Edmarici/maskLib/Radial_Stub_LPF/HFSS/rev21_analysis_report.txt

==============================================================================
Rev 21 close-out analysis - frozen configuration filter_BB_v4_pass9of9
  source: v6_confirm_S21.csv (2301 pts, 0.50-14.00 GHz, tight mesh)
==============================================================================

Q3 - BUFFER MODES ACROSS THEIR STATED +/-0.15GHz UNCERTAINTY
(no new solve; the scorecard already scores these rows as a worst-case)
  buffer 1  [4.35, 4.65] GHz, 31 solved pts: nominal -28.08, WORST -27.49 @ 4.580 GHz -> PASS (+7.49 dB)
  buffer 2  [4.85, 5.15] GHz, 31 solved pts: nominal -30.11, WORST -28.82 @ 4.920 GHz -> PASS (+8.82 dB)

Q2 - SENSITIVITY

  (a) GLOBAL perturbations - exact frequency rescale of the measured curve
      case                    bf 1    bf 2    st 1    st 2    st 3    st 4    st 5    st 6    st 7
      nominal               -27.49  -28.82  -28.54  -28.79  -27.06  -33.16  -21.43  -22.38  -22.56
      all lengths +0.25%    -27.49  -28.83  -30.75  -28.48  -27.12  -34.59  -21.61  -22.37  -22.64
      all lengths -0.25%    -27.49  -28.83  -26.15  -29.15  -27.00  -32.11  -21.23  -22.39  -22.49
      eps_eff +1%           -27.49  -28.82  -32.93  -28.21  -27.19  -36.69  -21.75  -22.35  -22.74
      eps_eff -1%           -27.17  -28.82  -23.39  -29.55  -26.94  -31.31  -21.00  -22.40  -22.43
      WORST                 -27.17  -28.82  -23.39  -28.21  -26.94  -31.31  -21.00  -22.35  -22.43
      margin                 +7.17   +8.82   +3.39   +8.21   +6.94  +11.31   +1.00   +2.35   +2.43
      -> below 20dB under any global perturbation: NONE

  (b) SINGLE-STUB 1% length error - nearest-null local shift (approximate)
      mode            GHz  nominal     worst    margin   nearest null
      buffer 1      4.500   -27.49    -21.09     +1.09   4.370 (S1), 130 MHz away
      buffer 2      5.000   -28.82    -28.82     +8.82   4.870 (S2), 130 MHz away
      storage 1     5.792   -28.54    -14.65     -5.35   5.900 (S6), 108 MHz away
      storage 2     6.160   -28.79    -27.79     +7.79   5.900 (S6), 260 MHz away
      storage 3     6.528   -27.06    -26.85     +6.85   6.970 (S4), 442 MHz away
      storage 4     6.897   -33.16    -30.16    +10.16   6.970 (S4), 73 MHz away
      storage 5     7.265   -21.43    -20.34     +0.34   7.550 (?), 285 MHz away
      storage 6     7.633   -22.38    -22.33     +2.33   7.550 (?), 83 MHz away
      storage 7     8.001   -22.56    -22.35     +2.35   7.550 (?), 451 MHz away
      -> below 20dB: storage 1

  (c) LINEWIDTH +/-5um - from the validated extraction, not modelled
      epseff_extraction_status.md records the field-plot-verified 6GHz point:
        w=70um  eps_eff 5.6795  Zpi 69.71 ohm
        w=125um eps_eff 5.6826  Zpi 69.70 ohm
      A 55um width change moves eps_eff <0.1% and Zpi ~0.01%. A +/-5um bias
      is ~1/11 of that, so <0.01% on both - negligible against the +/-1%
      eps_eff case above, which already passes. Expected physically: with no
      ground plane the mode is set by the bore, not the strip width.
      NOTE the same file records that the SWEPT eps_eff(f) data is
      non-physical and untrusted; only the 6GHz point is in use.

Q4 - DATA FOR THE NOTE

  (1) stub table
      stub    label       realized um   runs   gap um d_perp um  tee y um     fold
      S1      4.5GHz     8749.7213596      2     1000      1200   30000.0       -1
      S2      4.7GHz     9776.0927822      3      400      1000   27500.0       +1
      S3      5.3GHz     7395.2928339      2      400      1000   25000.0       +1
      S4      6.1GHz     5581.3136360      2      400      1000   22500.0       -1
      S5      7.0GHz     4307.8078628      2      400      1000   20000.0       +1
      S6      6.0GHz     7379.3226508      2      400      1000   17500.0       -1

  (2) null inventory, 0.5-14GHz, with HOW ownership was established
        4.370 GHz  S1   deletion   Rev19 B1 removed S1 and 4.325 vanished; tracked the Rev20 trim to 5MHz
        4.870 GHz  S2   assigned   never deletion-tested
        5.470 GHz  S3   assigned   never deletion-tested
        5.900 GHz  S6   deletion   Rev19 B4 removed S6 and this null vanished; moved with S6 length in Rev20 B3
        6.970 GHz  S4   deletion   Rev19 B1b census removed S4 and 6.890 vanished
        7.550 GHz  ?    unknown    needs S6 present (vanishes on S6 deletion) but ignores S6 length - Rev21 Q1
        8.730 GHz  S5   assigned   never deletion-tested
        9.965 GHz  -    unowned    survived S6 deletion AND three S6 lengths - explicitly NOT S6
       11.360 GHz  -    unowned    moved +2.3% while S6 grew 1.911x - not S6
       12.375 GHz  -    unowned    moved -1.3% while S6 grew 1.911x - not S6
      -> 3 of 10 deletion-confirmed; 3 assigned but never tested; 3 unowned.

  (3) k_eff on ONE definition
      DEFINITION A (used everywhere, verified below): k_eff = f_bare / f_null,
      f_bare = c/(4*L*sqrt(eps_eff)) with L = drawn centreline INCLUDING arc
      length, i.e. d_perp + turn_arc + n*run_length - the quantity
      folded_stub() solves and dims JSON reports as realized_length_um.
      case                                L um     null    k_eff   provenance
      foldexp 3run/400um             6987.9008    6.830   0.6589   isolated, Rev17 B2
      foldexp 2run/1000um            6987.9008    5.680   0.7923   isolated, Rev17 B2
      foldexp L-geometry             6987.9008    5.050   0.8911   isolated, Rev17 B2
      foldexp straight               6987.9008    5.450   0.8257   isolated, WIDE bore - not comparable
      S6 topology 2run/400um         6436.9032    6.780   0.7205   isolated, Rev20 B2
      S6 in cascade, old len         6436.9032    6.640   0.7357   cascade, Rev19 B4
      S6 in cascade, frozen          7379.3227    5.900   0.7223   cascade, Rev20 confirm
      S1 in cascade, pre-trim        8820.2836    4.340   0.8215   cascade, Rev19 B3
      S1 in cascade, frozen          8749.7214    4.370   0.8224   cascade, Rev20 confirm
      S2 in cascade, frozen          9776.0928    4.870   0.6605   cascade, ASSIGNED not tested
      RESOLVED: the suspected length-reference discrepancy does NOT exist.
      Every k_eff quoted in DESIGN_NOTES recomputes to <0.002 under
      definition A. The alternative (straight runs only, arcs excluded)
      would give k_eff > 1 for two cases, which is unphysical under the
      fold-cancellation reading, so it was never in use.
      The REAL inconsistency is the numerator: S6 was quoted at 0.6886,
      computed against the geometric MEAN of a null PAIR, while every other
      entry uses a measured null. That pair reading is withdrawn
      (sec 18.3), so 0.6886 is retired and replaced by 0.7357 (old length)
      / 0.7223 (frozen length). A second case: sec 14 quotes S2 at 0.664,
      which is 4.845GHz not the 4.760GHz the same sentence cites - again a
      numerator mismatch, not a length one.

  (4) mesh calibration
      probe (dS 0.02, ~1h) vs tight (dS 0.005, ~7h), measured on TWO geometries:
        Rev20 B1, pre-move geometry : mean 0.61 dB, worst 2.25 dB
        Rev20 B3, frozen geometry   : mean 0.45 dB, worst 1.85 dB
      worst row is buffer 2 both times - it is a worst-across-window row, so
      it samples wherever the grid lands. Scorecard work can use probe mesh.
      NULL POSITIONS are the exception: probe reads them a mean 14MHz (worst
      35MHz) LOW, same direction at all seven nulls, because an Interpolating
      sweep reconstructs sharp minima poorly. Length decisions need the
      discrete window.

  wrote C:\Users\epm114\Desktop\Masklib\Radial_Stub_LPF\HFSS\rev21_stub_table.csv

  wrote C:\Users\epm114\Desktop\Masklib\Radial_Stub_LPF\HFSS\rev21_keff_table.csv
  wrote C:\Users\epm114\Desktop\Masklib\Radial_Stub_LPF\HFSS\rev21_null_inventory.csv
==============================================================================
