Edmarici/maskLib/(list of files, cad)

Other CAD files:
Radial_Stub_LPF/DXF/filter_BB_CHIP_BB.dxf
Radial_Stub_LPF/DXF/filter_BB.dxf
