Edmarici/maskLib/(commit log)

2026-07-21 add fill_basemetal_from_xor helper to derive BASEMETAL fill from XOR gap layer
    merge()+hulls()+smoothed() over the XOR (CPW gap) layer to flood-fill the
    conductor footprint for XOR-convention chips, without bridging gaps
    between electrically distinct trace runs (an earlier bridging attempt
    shorted adjacent resonators - see the function's own docstring).
2026-07-21 add tapped_hairpin_filter and stepped_impedance_lpf CPW filter primitives
    Dimensions come straight from a Nuhertz Filter Solutions synthesis run
    (microstrip, Si, 500um) - a starting point, not final: this stack has no
    backside metal (CPW, not microstrip), so gap width still needs picking
    independently, and every length will need HFSS re-extraction once the
    real bare-chip/package environment is modeled (see the functions' own
    docstrings).
2026-07-21 add LC_Filter_* ladder-filter drawing helpers
    Standalone inductor/capacitor primitives (LC_Filter_ind1/ind2/
    ind_rects1/ind_rects2/cap1/cap2) for an LC ladder filter layout.
2026-07-21 add SNAIL standalone device combining FlagPads, JJ_chain, and flux_transformer
    Same composition as Snailmon3D but with pad and flux-transformer
    dimensions exposed as top-level parameters so a specific already-
    simulated design can be reproduced directly, including FlagPads' new
    flag_offset for its asymmetric pad pair.
2026-07-21 consolidate CPS line width/gap into shared params in Fast_Flux_Full
    Replaces the pad taper's hardcoded width/gap and the loop's separate
    thin_w/thin_s with one cps_w/cps_s pair reused end-to-end (taper, pads,
    hairpin filter via its new w/s override, loop), and drops two unused
    CPS_structure calls (c5/c6) and a redundant CPW_launcher call.
2026-07-24 ignore AEDT/HFSS solver-cache and generated output artifacts
    ~5000 untracked AEDT project/solver-cache files (.aedtresults/, .pyaedt/,
    lock/semaphore sidecars, ~1.1GB) had accumulated across Hairpin_Filter/ and
    Radial_Stub_LPF/ - every driver script in this repo regenerates its own
    .aedt project and geometry fresh from Python each run, so none of it is
    load-bearing. Also excludes .gds outputs (only .dxf was previously
    covered) and per-script HFSS/ analysis-output directories.
2026-07-24 add standalone hairpin bandpass filter test chip + HFSS S12 export
    n=4 Nuhertz-synthesized tapped CPW hairpin bandpass filter (~4.5GHz),
    launcher-to-launcher, with no stepped-impedance lowpass and no SNAIL
    keep-out - a clean two-port test structure for the bandpass filter alone,
    isolated from SNAIL_Pump_Filter.py's full floorplan. Every electrical
    dimension is a placeholder pending HFSS re-extraction in the real
    (CPW, package-grounded) environment. Hairpin_Filter_HFSS.py drives the S12
    export via hfssExport.py's GDS->HFSS bridge; verify_hfss_export.py is the
    local (no-Ansys) regression check on that geometry replay.
2026-07-24 add standalone SNAIL device test chip
    Asymmetric pad pair -> 3-big-JJ + 1-small-JJ loop -> flux-transformer
    coupler, via the new SNAIL() function in qubitLib.py. Verifies the SNAIL
    device geometry in isolation before wiring the flux transformer into a
    pump-line feed (SNAIL_Pump_Filter.py). Draws positive metal directly
    (FlagPads/JJ_chain/smallJJ/flux_transformer via SolidPline/dxf.rectangle),
    not the XOR-gap CPW convention used elsewhere in this codebase, so no
    fill_basemetal_from_xor step applies here.
2026-07-24 add SNAIL pump-filter floorplan sanity-check chip (Rev 2)
    Pump port (coupling-pin capacitive pad) -> n=4 Nuhertz-synthesized tapped
    CPW hairpin bandpass filter (~4.5GHz) -> stepped-impedance lowpass cleanup
    -> SNAIL keep-out, on a 7x40mm bare c-plane sapphire chip. Every electrical
    (CPW, package-grounded) environment - this pass is floorplan geometry only,
    not a tuned design. Out of scope: HFSS retuning, open-stub notches, actual
    SNAIL geometry (see SNAIL/SNAIL.py), the BASEMETAL XOR boolean (downstream
    in KLayout).
    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
2026-07-24 add L30/L45 radial-stub lowpass ladder family + HFSS verification
    Chebyshev II/elliptic butterfly-branch (stalk+fan) lowpass ladders, L30
    (orthogonal-branch variant included) and L45 - each shunt branch is a
    stalk (series L) + fan (shunt C), zero at the branch's series LC
    resonance. Predecessor to the L60 family and, later, the filter_BB
    quarter-wave-stub pivot (see notebooks/L*_design_notes.md for the full
    per-design derivation and HFSS findings). *_HFSS.py scripts drive the
    pyEPR driven-modal S21 extraction; verify_*.py scripts are the local
    (no-Ansys) geometry-replay regression checks each *_HFSS.py's geometry
    source depends on.
2026-07-24 add L60 elliptic fan-ladder filter + real Al cavity package sim
    Converged elliptic radial-stub ladder (fallback/comparison design,
    retained after the later filter_BB pivot). filter_L60_HFSS.py: Phase 1
    open-sim-volume/proxy-ground sanity run. filter_L60_package_HFSS.py:
    Phase 2, replaces the proxy ground with a real cylindrical PEC bore +
    sapphire substrate package model - the real-package sim that first showed
    the fan-ladder's shunt capacitance starving against the round bore wall
    (DESIGN_NOTES Sec. 5), motivating the filter_BB quarter-wave-stub pivot.
2026-07-24 add eps_eff/Zpi calibration pipeline for the bare-strip-in-bore line
    pyaedt wave-port eigenmode extraction (multi-mode Gamma/Zo post-processing
    pyEPR has no wrapper for): bare 70um/125um strip on anisotropic sapphire
    (9.4,9.4,11.6) in the real 7mm bore, single-frequency ports-only setups
    (a frequency sweep of the port solve was found to produce garbage - frozen
    port solution evaluated across the sweep, not real dispersion - see
    epseff_extraction_status.md). Measured eps_eff=5.681, |Zpi|~69.7ohm
    (width-independent) - the calibration filter_BB.py's quarter-wave stub
    lengths are built from. plot_epseff_mode.py renders the mode field for
    visual strip-vs-cavity-mode verification.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
2026-07-24 add Rev 11 elliptical/stadium-bore parametric study
    Tests whether flattening the package bore cross-section (oval/stadium,
    major axis fixed at 6.985mm, bore_h swept 6.985mm down to 1.0mm) restores
    enough shunt capacitance to resurrect the L60 fan-ladder and/or
    meaningfully shifts filter_BB's eps_eff. Three models: bare-strip
    eps_eff/Zpi (pyaedt multi-mode wave-port, oval_bore_epseff_HFSS.py), an
    unfolded real-P4-dimensioned branch pair and an unfolded filter_BB-style
    stub (pyEPR driven-modal S21 zero-finding, oval_bore_branch_stub_HFSS.py).
    oval_study_analysis.py merges the raw CSVs, plots, and computes the
    verdict against the study's explicit decision criteria.
    VERDICT (recorded in DESIGN_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
2026-07-24 add filter_BB quarter-wave stub pivot, Stage A protection sim, Rev 12 first light
    filter_BB.py (Rev 8 pivot): six-stub open-circuit quarter-wave band-block
    filter - zeros depend only on length and eps_eff, not capacitance to
    ground, so the fan-starved-in-the-round-bore failure mode that killed L60
    (see the oval-bore-study commit) cannot touch it. Rev 12: all stubs
    collapsed to 70um (measured |Zpi| is width-independent - width bought
    nothing), runtime report now prints target-vs-predicted f_zero per stub,
    and a dims JSON is exported for the HFSS quick-look pipeline.
    filter_BB_stageA_HFSS.py: real pin coupler + SNAIL-side lumped port,
    solves for Re[Z_snail](f) and coax->SNAIL transfer - the a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
2026-07-28 filter_BB: lock S7+v2 baseline geometry and pre-solve predictions (Rev 16)
    Fixes a real bug: bumping PREVIOUS_PASS_DIMS_JSON/DASHBOARD_CSV to pass-3's
    own output projected an unintended further f~1/L correction onto S2-S6
    (the intent was "S1 frozen at v2, S2-S6 unchanged from pass-3" per Rev 15's
    own definition). S2-S6 are now frozen via explicit dl_um constants copied
    from their pass-3 dl_um_seed values; PREVIOUS_PASS_* point at nonexistent
    files so no stub gets a live-recomputed seed anymore.
    filter_BB_circuit_model.py: fixed a null-to-stub matching bug (per-label
    nearest-search could double-assign one model null to two labels - S3/S4
    both matched 5.633GHz identically) by switching to the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
    [s7v2_predictions.csv]
2026-07-30 filter_BB v3: quantify the fold penalty, adopt an L-stub for S1, drop S7 (Rev 17)
    Fold-geometry experiment (new filter_BB_fold_experiment_HFSS.py): one stub
    alone on a matched through-line, four geometries at an IDENTICAL 6987.9um
    drawn length, all in the real 7000um bore. Measured k_eff (= bare quarter-wave
    frequency / measured null frequency; 1.0 = drawn length resonates where
    lambda/4 says):
    3 parallel runs, 400um gap -> 6.830GHz, k_eff 0.659
    2 parallel runs, 1000um gap -> 5.680GHz, k_eff 0.792
    L, single bend, 2500um standoff -> 5.050GHz, k_eff 0.891
    Monotonic in both fold count and run gap - antiparallel adjacent runs cancel,
    shortening the effective electrical length and pushin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
    [foldexp_results.csv]
2026-07-31 bank filter_BB v3 results and tag it (Rev 18 D0)
    v3 is the first configuration to pass the SNAIL criterion: S21@4.5GHz =
    -33.56dB vs a <=-20dB target (v2+S7 was -10.94dB).
    Geometry: S1 = L-stub @7841.97um targeting 4.5GHz, S7 deleted, S2-S6 frozen.
    filter_BB.py at this commit is the source of truth; DXF/GDS regenerate from it
    with identical geometry (verified: dims JSON hash stable across runs, merged
    region 1 polygon / 7476841.79um^2). Their file hashes do churn per-run, but
    only from the DXF header's TDCREATE/TDUPDATE timestamps, so the blobs
    themselves are not committed - the dims JSON is the deterministic record.
    Force-added because HFSS/ is gitignored; these solve outputs cost hours o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
    [v3_confirm_S21.csv, v3_confirm_convergence.csv, v3_confirm_dashboard.csv, v3_confirm_needles.csv, v3_confirm_passband.csv, v3_confirm_valleys.csv]
2026-07-31 filter_BB: refold S1 as a wide-gap single fold pointing away from S3 (Rev 18)
    v3's L-stub put S1's open end 783um from S3's fan - the tightest pair in the
    design, and both are voltage antinodes - and S3's -66dB notch vanished from the
    v3 sweep. This refolds S1 to keep its length while moving its far end away.
    S1: 2 runs at a 1000um gap (bend radius 535um), d_perp 1200um, folded NORTH.
    Drawn length 8820.28um, from the fold experiment's measured k_eff 0.792 for
    this exact geometry. S2-S6 and all six tee positions are byte-identical
    (verified field-by-field against the filter_BB_v3 tag's dims JSON).
    The handoff specified a SOUTHWARD fold turning back before S3's latitude.
    That is geometricall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
2026-07-31 filter_BB: Rev 18 probe result + six revisions of design notes (Rev 12-18)
    BB_design_notes.md had been unwritten since the first pre-HFSS build - it
    still listed EPS_EFF=5.5 as an open placeholder and a 4.2GHz S1. Adds Part
    II covering Rev 12-18: the impedance triple, the measured fold penalty and
    the architecture rule it implies, v3 as the first passing configuration,
    the unresolved null attribution, the S1<->S3 coupling and this refold, and
    the process lessons. Marks the old sections as historical rather than
    deleting them - the method notes still apply.
    Rev 18 probe: CASE 1. The 4.7-5.3GHz hole improved 14.85dB (-7.39 ->
    -22.23dB) and S21@4.5GHz still passes at -23.08dB. But the hole mov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
    [v3f_singlefold_S21.csv]
2026-07-31 filter_BB: Rev 19 B0 mode-comb scorecard + B1 deletion test harness
    New acceptance spec is a 9-row table lookup at discrete mode frequencies,
    not a worst-in-band scan. Buffer rows report the WORST S21 across the full
    +/-0.15GHz uncertainty rather than the value at the nominal centre - a
    narrow null centred on 4.5GHz that degrades at 4.65GHz is not protection.
    B0 result: probe and v3 BOTH score 8/9. They differ in which mode flags -
    probe at storage 1 (5.792GHz, -18.21dB, 1.8dB short), v3 at buffer 2
    (5.000GHz, -7.39dB, 12.6dB short). So the probe is ahead on severity, but
    not 8-vs-5 as the handoff estimated, and its margin structure is thinner:
    3 of 9 modes within 2dB of the line versus v3s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
    [comb_scorecard.csv]
2026-07-31 filter_BB: Rev 19 B1 - S1 identified by deletion, and it owns 4.325GHz
    Deleting S1 removes the 4.325GHz null and no other. Settles the attribution
    question open since Rev 16, and corrects Rev 18s probe report, which named
    4.855GHz as S1s null - that is wrong, 4.855 survives S1s deletion.
    Coupling, measured rather than inferred: S1 shifts only its nearest
    neighbour (4.855 -> 4.800, -1.1%). The 5.480/6.890/8.135 nulls move
    <=0.36%, at or below the noise floor for two runs solved at different mesh
    settings. This undercuts Rev 18s reading that S1 was strongly hybridising
    with S3 - if deleting S1 outright barely moves that null, S1 cannot explain
    the 6.6% v3->probe shift attributed to it.
    B2 as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
    [v3f_delete_S1_S21.csv]
2026-07-31 filter_BB: Rev 19 B1b - full-range null census + S4 deletion test
    Two questions, one script, deliberately mesh-matched.
    Q1: sweeps 0.5-14GHz before anyone concludes a stub is dead. Every missing
    notch in this campaign so far has been a search window that was too narrow,
    and the Rev 18 probe only looked at 3.5-9.0GHz. If six nulls exist over the
    full range then nothing is missing and repair beats adding a 7th stub.
    Q2: deletes S4 to find which null is its own and which neighbour moves.
    B1 ruled S1 out as a coupling partner but that does not rule out
    hybridisation elsewhere - S3/S4 and S4/S5 are the remaining candidates and
    this discriminates.
    Both designs build at the SAME 6.0GHz single-po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
2026-07-31 filter_BB: Rev 19 B1b - 12 nulls not 5, S4 owns 6.890GHz, S4-S5 coupling measured
    Q1: the intact filter has 12 nulls over 0.5-14GHz, seven of them above
    9.0GHz where the Rev 18 probe never looked. The 5-nulls-for-6-stubs mystery
    was a search-window artifact, the same failure mode as every earlier
    missing-notch error. Nothing is missing; repair beats adding a 7th stub.
    Q2: deleting S4 removes the 6.890GHz null. S4 is the second stub identified
    by deletion. I had guessed 6.890 was S5 - wrong, and that is the second
    attribution guess this revision has overturned.
    Coupling FOUND, at matched mesh: deleting S4 moves the 8.125GHz null to
    8.375GHz, +3.1%. That is ~10x S1s effect and well clear of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
    [v3f_census_delS4_S21.csv, v3f_census_intact_S21.csv]
2026-07-31 filter_BB: Rev 19 B2 - retarget S6 from 8.0 to 5.98GHz (unfreezes S6)
    S6's null sat at 9.970GHz, above the 8.001GHz top of the mode comb, so it
    contributed nothing to the acceptance spec - storage 7 is covered by S5's
    8.125 null. Moving it to 5.98GHz, the midpoint of the two comb modes
    stranded in the 1.410GHz gap between S3 (5.480) and S4 (6.890), puts
    storage 1 and storage 2 each ~185MHz from a null instead of bullseyeing one
    and leaving the other exposed. Resulting spacings 0.500 and 0.910GHz, both
    inside the <=1.0GHz valley rule.
    Length from S6's OWN measured k_eff (bare 8.1447 / null 9.970 = 0.81692):
    6436.90um drawn, dl_um 1178.4494. Not extrapolated from another stub's
    geometry - tha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
2026-07-31 filter_BB: Rev 19 B3 - S6 retarget did NOT land; inferred assignment refuted
    The 9.970GHz null survived at 9.965GHz after S6 was lengthened x1.667, and
    no null appeared near the 5.98GHz target. 9.970 was never S6's, so the
    k_eff-consistency assignment in e196cce was wrong and the length computed
    from it (6436.90um) has no basis. The confirmation script's own self-check
    caught this rather than the result being read as a success.
    Design status, mesh matched to v3 (delta_S 0.005, 5 passes, final 0.0012):
    8/9 PASS, same as before. Every mode improved except the one this change
    targeted - storage 1 went -18.13 -> -15.76dB, so the sole flag got 2.4dB
    WORSE while buffer 1/2 gained ~2.5dB each and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
    [v4_comb_S21.csv, v4_comb_comb_scorecard.csv]
2026-08-01 filter_BB: Rev 19 B4 - S6 owns a null PAIR (6.640 + 7.580GHz), measured
    Cleanest attribution of the campaign: S6 deleted at B3's exact mesh, via the
    same script with --delete so configuration cannot drift. Two nulls vanish,
    6.640 and 7.580GHz. Every other null survives within 0.3%.
    S6 does not produce one null, it produces a SPLIT PAIR - ratio 1.1416,
    i.e. +/-6.84% about a geometric mean of 7.094GHz. That is why every
    k_eff-consistency assignment this revision failed: they all assumed one null
    per stub. It also explains the census finding exactly 12 nulls for 6 stubs.
    S6's real k_eff to the pair centre is 0.6886, not the 0.8169 assumed in B2,
    so the retarget landed 18.6% high - at 7.094GHz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
    [v4_delS6_S21.csv, v4_delS6_comb_scorecard.csv]
2026-08-01 filter_BB: Rev 20 tooling - probe-mesh option + split-pair gap harness
    Three tooling changes, no geometry touched yet.
    1. filter_BB_rev19_confirm_HFSS.py gains --mesh probe|confirm.
    The Rev 20 handoff asks for B1 (the S1 trim) at probe settings because a
    confirm-mesh solve costs ~7h here against ~1h for a probe one. But a
    probe-mesh scorecard cannot be read on absolute dB against B3/B4's
    confirm-mesh numbers, and storage 1's flag status is a threshold call with
    only 4.2dB in it - comparing across meshes is exactly the confound that
    made B3 unattributable.
    So B1 runs as a PAIR at probe mesh: untrimmed baseline first, then the
    trim, and the trim is judged on the mesh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
2026-08-01 filter_BB: Rev 20 B2 - two disk-only findings on the split pair, no solve spent
    Both come from re-reading files already on disk. No AEDT time.
    FINDING 1 - no isolated fold variant ever produced a pair.
    Re-read the Rev 17 fold experiment's own saved 0.5-14GHz coarse sweeps
    (HFSS/foldexp_*_S21.csv). Each variant has exactly ONE resonance across the
    full band: V-fold-current 6.830GHz, V-fold-wide 5.680GHz, V-L 5.045GHz. With
    the depth threshold removed entirely each trace has four local minima - the
    real null plus three shallow features near 1.9, 8.1 and 11.6GHz that sit
    within a few hundred MHz of each other across all three variants and are
    therefore harness artifacts, not stub resonances.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
2026-08-01 filter_BB: Rev 20 B1 - trim S1 70.56um, and a mesh calibration worth having
    BASELINE (v5_base, probe mesh, untrimmed) - 8/9 PASS, storage 1 -15.75 FLAG.
    THE UNEXPECTED RESULT: the probe mesh reproduces the confirm mesh almost
    exactly. Same geometry, delta_S 0.02 / 4 passes / adaptive 6.0GHz against
    delta_S 0.005 / 5 passes / adaptive 3.5GHz:
    buffer 1 -24.92 vs -25.44 storage 3 -37.66 vs -37.10
    buffer 2 -22.29 vs -24.54 storage 4 -39.28 vs -40.26
    storage 1 -15.75 vs -15.76 storage 5 -21.74 vs -21.09
    storage 2 -23.80 vs -23.60 storage 6 -23.60 vs -23.76
    storage 7 -23.70 vs -23.88
    Mean |diff| 0.61dB, worst 2.25dB at buffer 2 (a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
    [v5_base_comb_scorecard.csv]
2026-08-01 filter_BB: Rev 20 B1 result - trim works as designed, storage 1 STILL FLAGS
    Mesh-matched pair, both probe mesh, 4 passes each. Only S1's length differs.
    mode GHz base trim change
    buffer 1 4.500 -24.92 -25.82 -0.90
    buffer 2 5.000 -22.29 -23.35 -1.06
    storage 1 5.792 -15.75 -15.84 -0.09 FLAG
    storage 2 6.160 -23.80 -23.91 -0.11
    storage 3 6.528 -37.66 -37.79 -0.13
    storage 4 6.897 -39.28 -39.43 -0.15
    storage 5 7.265 -21.74 -22.03 -0.29
    storage 6 7.633 -23.60 -23.84 -0.24
    storage 7 8.001 -23.70 -23.83 -0.13
    Every mode improved, none got worse. S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
    [v5_trim_comb_scorecard.csv]
2026-08-01 filter_BB: Rev 20 B2 result + B3 - S6 has NO pair in isolation; move it anyway
    B2 RESULT. S6's exact topology - 2 runs, 400um gap, its own 6436.90um length -
    alone on a through-line in the real 7000um bore produces ONE null at 6.780GHz
    (coarse and 10MHz discrete agree). Not a pair.
    The gate stopped the sweep there rather than spending two more solves mapping
    a gap-to-span trend the harness cannot see. G-1000/G-1500 not run.
    WHAT THAT KILLS: the handoff's candidate (b) - the same move with the run gap
    widened to retune the pair's span. There is no measured gap-to-span law, so
    (b) cannot be specified, let alone ranked. The Rev 20 B4 plan of specifying a
    seventh stub as a designed two-notch e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
    [splitpair_gap_sweep.csv]
2026-08-02 filter_BB: Rev 20 B3 - 9/9 PASS, and the reasoning that got there was wrong
    FIRST 9/9 OF THE CAMPAIGN. S6 at 7379.32um, probe mesh, 7 passes, dS 0.0106:
    1 buffer 1 4.500 -27.55 PASS +7.6 6 storage 4 6.897 -32.86 +12.9
    2 buffer 2 5.000 -26.97 PASS +7.0 7 storage 5 7.265 -22.01 +2.0
    3 storage 1 5.792 -28.33 PASS +8.3 8 storage 6 7.633 -22.68 +2.7
    4 storage 2 6.160 -28.54 PASS +8.5 9 storage 7 8.001 -22.87 +2.9
    5 storage 3 6.528 -27.03 PASS +7.0
    storage 1 went -15.84 -> -28.33dB. The flag is gone and no new one appeared.
    THE LOCKED PREDICTION SCORED 4/9. Recorded because the design result does not
    make the reasoning right: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
    [v6_s6move_comb_scorecard.csv]
2026-08-02 filter_BB: Rev 20 - 9/9 CONFIRMED at tight mesh. The filter passes.
    Confirm mesh, delta_S 0.005, 5 passes, final delta-S 0.0018621.
    mode GHz before after change margin
    buffer 1 4.500 -25.44 -27.49 -2.05 +7.5
    buffer 2 5.000 -24.54 -28.82 -4.28 +8.8
    storage 1 5.792 -15.76 -28.23 -12.47 +8.2
    storage 2 6.160 -23.60 -28.79 -5.19 +8.8
    storage 3 6.528 -37.10 -27.06 +10.04 +7.1
    storage 4 6.897 -40.26 -33.36 +6.90 +13.4
    storage 5 7.265 -21.09 -21.38 -0.29 +1.4
    storage 6 7.633 -23.76 -22.38 +1.38 +2.4
    storage 7 8.001 -23.88 -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
    [v6_confirm_S21.csv, v6_confirm_comb_scorecard.csv]
2026-08-02 DESIGN_NOTES: sec 18 (Rev 20, 9/9) and sec 15's argument withdrawn
    Sec 18 records the passing configuration and, more usefully, four reusable
    results and one retraction:
    18.1 mesh economics - probe mesh matches confirm to 0.45-0.61dB mean,
    measured twice on two geometries, with buffer 2 reproducibly the most
    sensitive row. But null POSITIONS read a mean 14MHz low on an
    interpolating sweep, so every length decision must use the discrete
    window. That distinction is the whole reason the S1 trim landed.
    18.2 length edits need no k_eff: L_new = L_old * f_old/f_new, confirmed on
    two solves. Every k_eff round trip this campaign tried was percent-
    level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
2026-08-02 filter_BB: freeze the 9/9 passing configuration as v4_pass9of9
    D0 of the Rev 21 handoff. No geometry change - this commit only banks what
    already passes, plus the evidence that it rebuilds.
    FROZEN ARTIFACTS. DXF and GDS are normally gitignored here; force-added at
    this one point on explicit instruction, because a frozen fabrication artifact
    is the whole point of the tag. Also banked: dims JSON, the tight-mesh merged
    sweep and scorecard, and the probe-mesh sweep of the same geometry (kept for
    the mesh-calibration record, not as a result).
    REPRODUCIBILITY VERIFIED, not assumed. Re-running filter_BB.py gives:
    dims JSON bit-identical (sha256 e39c567a...)
    DXF differs in exactly 2 v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
    [filter_BB.dxf, filter_BB_CHIP_BB.dxf, v6_s6move_S21.csv]
2026-08-02 filter_BB: Rev 21 Q2/Q3/Q4 - close-out analysis, no solves
    All from artifacts on disk. One script, reproducible against the
    filter_BB_v4_pass9of9 tag.
    Q3 - BUFFER MODES PASS ACROSS THEIR FULL UNCERTAINTY, not just at nominal:
    buffer 1 [4.35, 4.65]: worst -27.49dB @4.580 -> PASS by 7.49dB
    buffer 2 [4.85, 5.15]: worst -28.82dB @4.920 -> PASS by 8.82dB
    So the stronger claim is available: it passes across the stated +/-0.15GHz,
    not merely at 4.500/5.000.
    Q2 - SENSITIVITY. Global perturbations are done by rescaling the MEASURED
    curve, not modelled: a uniform change in all lengths, or in eps_eff, rescales
    the whole S21(f) response in frequency for a non-dispersive TEM structure, so
    the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
    [rev21_keff_table.csv, rev21_null_inventory.csv, rev21_stub_table.csv]
2026-08-02 notes: bring the master SNAIL filter notes in-repo, corrected to v2.1
    Moved from Downloads into Radial_Stub_LPF/notebooks/ alongside the other
    design notes. Content reconciled against the frozen filter_BB_v4_pass9of9 tag
    and this session's measurements.
    ONE SIGNIFICANT FACTUAL ERROR CORRECTED. v2's Sec. 3.2 described S1 as an
    L stub - "2500 um perpendicular standoff, one arc, axial run" - drawn
    7771.41 um. S1 has not been an L since Rev 18. It is a 2-run meander at a
    1000 um run gap and 1200 um standoff, drawn 8749.72 um. The L was replaced
    precisely because its axial run left S1's open end 783 um from S3's fan, two
    voltage antinodes facing each other. The 7771.41 figure mixes revisions: it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
2026-08-02 filter_BB: Rev 21 Q1 closed - a zero can belong to a PAIR of stubs; S6 fan added
    Q1. The 7.515GHz zero had resisted attribution for two revisions: it vanishes
    when S6 is deleted, yet ignores S6's length (14.64% length change -> 0.40%
    shift). Deleting S4 and S5 in turn at the frozen geometry, same mesh:
    owner intact del S4 del S5
    S1 4.350 4.340 4.340
    S2 4.850 4.850 4.850
    S3 5.470 5.480 5.510
    S6 5.900 5.925 5.910
    S4 6.970 VANISH 7.135
    ??? 7.515 7.215 VANISH (-4.0% under S4, dies under S5)
    S5 8.710 8.655 VANISH
    THE ZERO REQUIRES BOTH S5 AND S6. Deleting either partner destroys it;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
    [v7_delS4_comb_scorecard.csv, v7_delS5_comb_scorecard.csv]
2026-08-03 filter_BB: lock the S6 fan prediction before solving
    Six numbered predictions with a mesh-matched baseline (v6_s6move: same probe
    settings, same 7379.3227um drawn length, no fan), plus four named falsifiers.
    The one that decides the change: the zero must BROADEN, not merely move. If
    it moves without broadening the fan is acting as a length extension only, the
    Q2 fragility is unfixed, and the honest response is to revert it and instead
    lengthen S6 1.86% to centre the zero - a simpler change, already quantified.
    Explicitly NOT predicted: where the 7.515GHz S5+S6 two-body zero lands.
    Nothing measured so far constrains how it responds to a change in S6's
    TERMINATION as opposed to its LENGTH. R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
2026-08-03 filter_BB: fan assessment harness, and a correction to the locked prediction
    CORRECTION, disclosed rather than silently edited. The locked prediction's
    width row originally read "-30dB width, 63 MHz". That metric cannot detect
    what it was meant to detect: the composite floor is ALREADY below -30dB
    across 5.60-6.10GHz, so an absolute threshold measures the neighbouring stubs,
    not S6. That is precisely the effect master-notes Sec. 2.3 warns about and I
    walked into it. The 63 MHz figure was also never measured - it was written
    from memory.
    Replaced with the local-baseline convention the fold experiment already uses
    (baseline = mean over +/-0.25..0.5GHz excluding the zero). On that metric the
    r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
2026-08-03 filter_BB: S6 fan WORKS - the fragility is fixed, by a mechanism I predicted wrong
    9/9 retained, and the Q2 fragility is gone. Mesh-matched against v6_s6move
    (same probe settings, same 7379.3227um drawn length, fan is the only change).
    THE RESULT THE FAN WAS ADDED FOR - storage 1 under a +/-1% S6 length error:
    NO FAN WITH FAN
    nominal -28.65 -28.24
    worst over +/-1% -15.66 -26.92
    margin vs -20dB -4.34 +6.92
    swing over the range 22.66 2.62 dB
    flatness, storage 1 +/-100MHz: 44.07dB swing -> 4.11dB swing
    worst transmission peak in 5.5-6.1GHz:
    no fan -9.35dB at 5.715GHz, only 77MHz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
    [v8_s6fan_S21.csv, v8_s6fan_comb_scorecard.csv]
2026-08-03 notes: fan result (sec 3.10) + a newly quantified risk at the lower band edge
    SEC 3.10 - the S6 fan, and the mechanism it actually used. Fixes the Sec. 3.7
    fragility: storage 1's worst case under a +/-1% S6 error goes -15.66 -> -26.92dB,
    its swing 22.62 -> 2.62dB, and the whole comb goes 8/9 -> 9/9 under that test.
    The transferable part is that the fan did NOT widen a notch - it DISSOLVED
    one. The -102dB zero at 5.900 is gone, replaced by a -24 to -30dB shelf across
    5.65-6.10GHz. Storage 1 stopped caring where the feature sits because it is no
    longer near a sharp feature. Stated plainly in the notes: this makes the
    filter deliberately shallower and flatter, which costs nothing under a
    mode-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
2026-08-03 filter_BB: regenerate tracked DXF/GDS to match HEAD (S6 fan)
    The DXF/GDS became tracked at the v4 freeze, on explicit instruction, so they
    now go stale on every geometry change. Regenerated to match filter_BB.py as it
    stands. Real geometry difference, verified rather than assumed: klayout XOR
    against the committed copy is 70829.3 um^2 on layer 2/0, which is the S6 fan -
    a 90deg sector from r_in 49.50 to r_out 300um is 68760 um^2, plus its ~54.5 x
    70um taper, less the overlap at the joint.
    NOT a new design state. This is the same probe-mesh-validated fan geometry
    already committed in filter_BB.py; only the generated artifacts are catching
    up. The tight-mesh confirmation is still running, and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
    [filter_BB.dxf, filter_BB_CHIP_BB.dxf]
